Greg-R/t41_2_main_board/README.md

T41-2 Main Board Module

The documentation for this design is located here:
<https://kf5n.com/t41-2/main/>
