Greg-R/t41_2_main_board/doc/t41_2_main_board.pdf

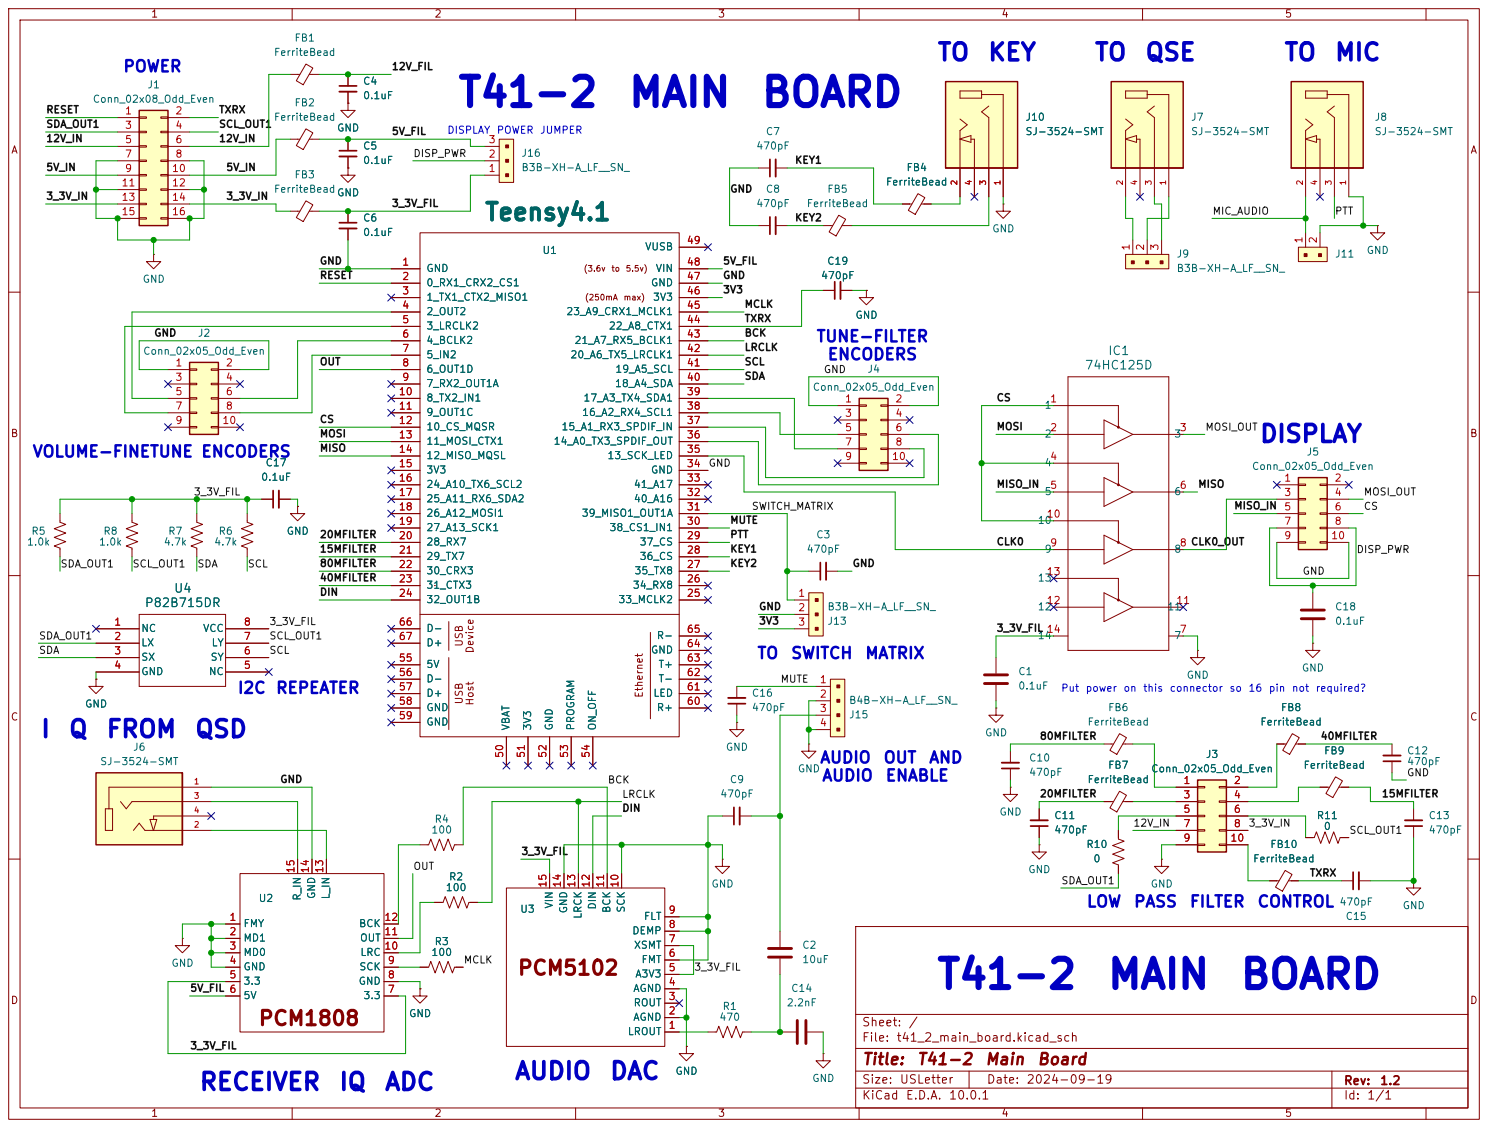
[picture p1: page 1]

DISPLAY POWER JUMPER T41-2 MAIN BOARD

Put power on this connector so 16 pin not required?

LRC 10 OUT 11 BCK 12 L_IN 13 GND 14 R_IN 15 U2 GND

LOW PASS FILTER CONTROL

Size: USLetter | Rev: 1.2
KiCad E.D.A. 10.0.1 | Id: 1/1
