Greg-R/t41_2_main_board/(list of files, drawings)

Other design files:
t41_2_main_board.dsn
