Greg-R/t41_2_main_board/t41_2_main_board.kicad_pcb

## KiCad design t41_2_main_board.kicad_pcb (2024-09-19)

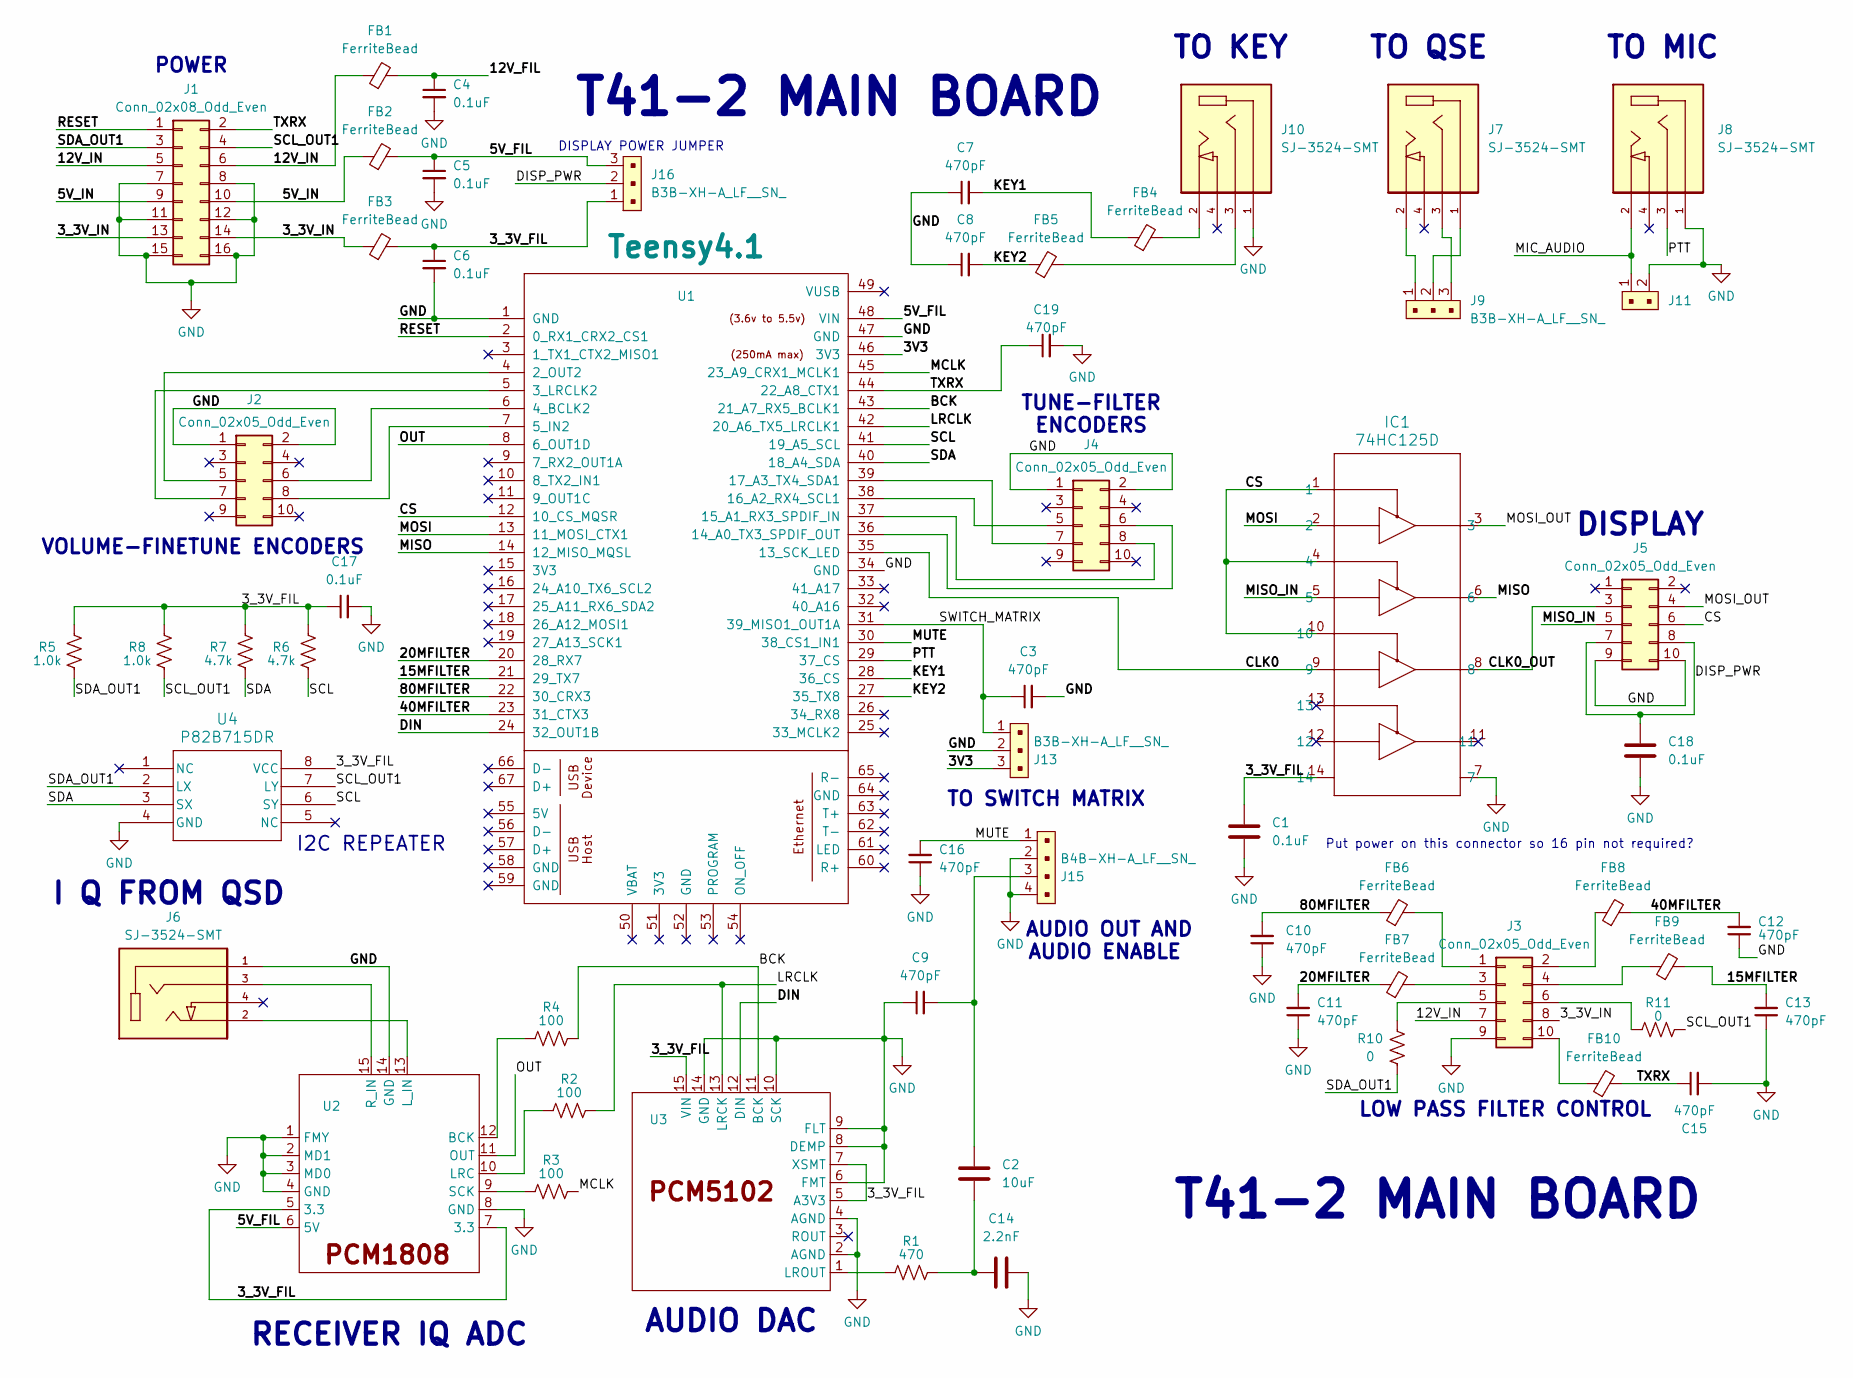
[picture p2: schematic t41_2_main_board.kicad_sch, T41-2 Main Board]

Parts:
C1, C4, C5, C6, C17, C18: 0.1uF; C_1206_3216Metric
C2: 10uF; C_1206_3216Metric
C3, C7, C8, C9, C10, C11, C12, C13, C15, C16, C19: 470pF; C_1206_3216Metric
C14: 2.2nF; C_1206_3216Metric
FB1, FB2, FB3, FB4, FB5, FB6, FB7, FB8, FB9, FB10: FerriteBead; L_1206_3216Metric
IC1: 74HC125D; SOIC-14_3.9x8.7mm_P1.27mm
J1: Conn_02x08_Odd_Even; IDC-Header_2x08_P2.54mm_Vertical
J2, J3, J4, J5: Conn_02x05_Odd_Even; IDC-Header_2x05_P2.54mm_Vertical
J6, J7, J8, J10: SJ-3524-SMT; CUI_SJ-3524-SMT; PARTREV 1.03
J9, J13, J16: B3B-XH-A_LF__SN_; PinHeader_1x3_P2.5mm_Drill1.1mm; MPN B3B-XH-A(LF)(SN); Digi-Key_PN 455-2248-ND
J11: B2B-XH-A_LF__SN_; PinHeader_1x2_P2.5mm_Drill1.1mm; MPN B2B-XH-A(LF)(SN); Digi-Key_PN 455-2247-ND
J15: B4B-XH-A_LF__SN_; PinHeader_1x4_P2.5mm_Drill1.1mm; MPN B4B-XH-A(LF)(SN); Digi-Key_PN 455-2249-ND
R1: 470; R_1206_3216Metric
R2, R3, R4: 100; R_1206_3216Metric
R5, R8: 1.0k; R_1206_3216Metric
R6, R7: 4.7k; R_1206_3216Metric
R10, R11: 0; R_1206_3216Metric
U1: Teensy4.1; Teensy41
U2: PCM1808_module
U3: PCM5102_module
U4: P82B715DR; SOIC-8_3.9x4.9mm_P1.27mm

Connections:
/3V3: J13.3, U1.46 (3V3)
/3_3V_FIL: C1.1, C6.1, C17.1, FB3.2, IC1.14, J16.1, R5.2, R6.2, R7.2, R8.2, U2.5 (3.3), U2.7 (3.3), U3.5 (A3V3), U3.7 (XSMT), U3.15 (VIN), U4.8 (VCC)
/3_3V_IN: FB3.1, J1.13, J1.14, J3.8
/5V_FIL: C5.1, FB2.2, J16.3, U1.48 (VIN), U2.6 (5V)
/5V_IN: FB2.1, J1.9, J1.10
/12V_FIL: C4.1, FB1.2
/12V_IN: FB1.1, J1.5, J1.6, J3.7
/15MFILTER: C13.2, FB9.2, U1.21 (29_TX7)
/20MFILTER: C11.2, FB7.1, U1.20 (28_RX7)
/40MFILTER: C12.2, FB8.2, U1.23 (31_CTX3)
/80MFILTER: C10.2, FB6.1, U1.22 (30_CRX3)
/BCK: R4.2, U1.43 (21_A7_RX5_BCLK1), U3.11 (BCK)
/CLK0: IC1.9, U1.35 (13_SCK_LED)
/CLK0_OUT: IC1.8, J5.3
/CS: IC1.1, IC1.4, IC1.10, J5.6, U1.12 (10_CS_MQSR)
/DIN: U1.24 (32_OUT1B), U3.12 (DIN)
/DISP_PWR: C18.1, J5.7, J5.8, J16.2
/KEY1: C7.2, FB4.1, U1.28 (36_CS)
/KEY2: C8.2, FB5.1, U1.27 (35_TX8)
/LRCLK: R2.2, U1.42 (20_A6_TX5_LRCLK1), U3.13 (LRCK)
/MCLK: R3.2, U1.45 (23_A9_CRX1_MCLK1)
/MIC_AUDIO: J8.2, J11.1
/MISO: IC1.6, U1.14 (12_MISO_MQSL)
/MISO_IN: IC1.5, J5.5
/MOSI: IC1.2, U1.13 (11_MOSI_CTX1)
/MOSI_OUT: IC1.3, J5.4
/MUTE: C16.2, J15.1, U1.30 (38_CS1_IN1)
/OUT: U1.8 (6_OUT1D), U2.11 (OUT)
/PTT: J8.3, U1.29 (37_CS)
/RESET: J1.1, U1.2 (0_RX1_CRX2_CS1)
/SCL: R6.1, U1.41 (19_A5_SCL), U4.6 (SY)
/SCL_OUT1: J1.4, R8.1, R11.2, U4.7 (LY)
/SDA: R7.1, U1.40 (18_A4_SDA), U4.3 (SX)
/SDA_OUT1: J1.3, R5.1, R10.1, U4.2 (LX)
/SWITCH_MATRIX: C3.1, J13.1, U1.31 (39_MISO1_OUT1A)
/TXRX: C15.1, C19.1, FB10.2, J1.2, U1.44 (22_A8_CTX1)
GND: C1.2, C3.2, C4.2, C5.2, C6.2, C7.1, C8.1, C9.1, C10.1, C11.1, C12.1, C13.1, C14.1, C15.2, C16.1, C17.2, C18.2, C19.2, IC1.7, J1.7, J1.8, J1.11, J1.12, J1.15, J1.16, J2.1, J2.2, J3.9, J4.1, J4.2, J5.9, J5.10, J6.1, J8.1, J10.1, J11.2, J13.2, J15.2, J15.4, U1.1 (GND), U1.34 (GND), U1.47 (GND), U2.1 (FMY), U2.2 (MD1), U2.3 (MD0), U2.4 (GND), U2.8 (GND), U2.14 (GND), U3.2 (AGND), U3.4 (AGND), U3.6 (FMT), U3.8 (DEMP), U3.9 (FLT), U3.10 (SCK), U3.14 (GND), U4.4 (GND)
unnamed: C2.2, C9.2, J15.3
unnamed: C2.1, C14.2, R1.2
unnamed: FB4.2, J10.2
unnamed: FB5.2, J10.3
unnamed: J2.5, U1.4 (2_OUT2)
unnamed: J2.6, U1.6 (4_BCLK2)
unnamed: J2.7, U1.5 (3_LRCLK2)
unnamed: J2.8, U1.7 (5_IN2)
unnamed: FB6.2, J3.1
unnamed: FB8.1, J3.2
unnamed: FB7.2, J3.3
unnamed: FB9.1, J3.4
unnamed: J3.5, R10.2
unnamed: J3.6, R11.1
unnamed: FB10.1, J3.10
unnamed: J4.5, U1.38 (16_A2_RX4_SCL1)
unnamed: J4.6, U1.36 (14_A0_TX3_SPDIF_OUT)
unnamed: J4.7, U1.39 (17_A3_TX4_SDA1)
unnamed: J4.8, U1.37 (15_A1_RX3_SPDIF_IN)
unnamed: J7.1, J9.2
unnamed: J7.2, J9.1
unnamed: J7.3, J9.3
unnamed: R4.1, U2.12 (BCK)
unnamed: R2.1, U2.10 (LRC)
unnamed: J6.2, U2.13 (L_IN)
unnamed: J6.3, U2.15 (R_IN)
unnamed: R3.1, U2.9 (SCK)
unnamed: R1.1, U3.1 (LROUT)

Notes on the sheet:
TO QSE
ENCODERS
TO SWITCH MATRIX
VOLUME-FINETUNE
I2C REPEATER
TO MIC
AUDIO OUT AND
I Q FROM QSD
TUNE-FILTER
DISPLAY POWER JUMPER
RECEIVER IQ ADC
DISPLAY
TO KEY
T41-2 MAIN BOARD
AUDIO ENABLE
Put power on this connector so 16 pin not required?
AUDIO DAC
POWER
LOW PASS FILTER CONTROL

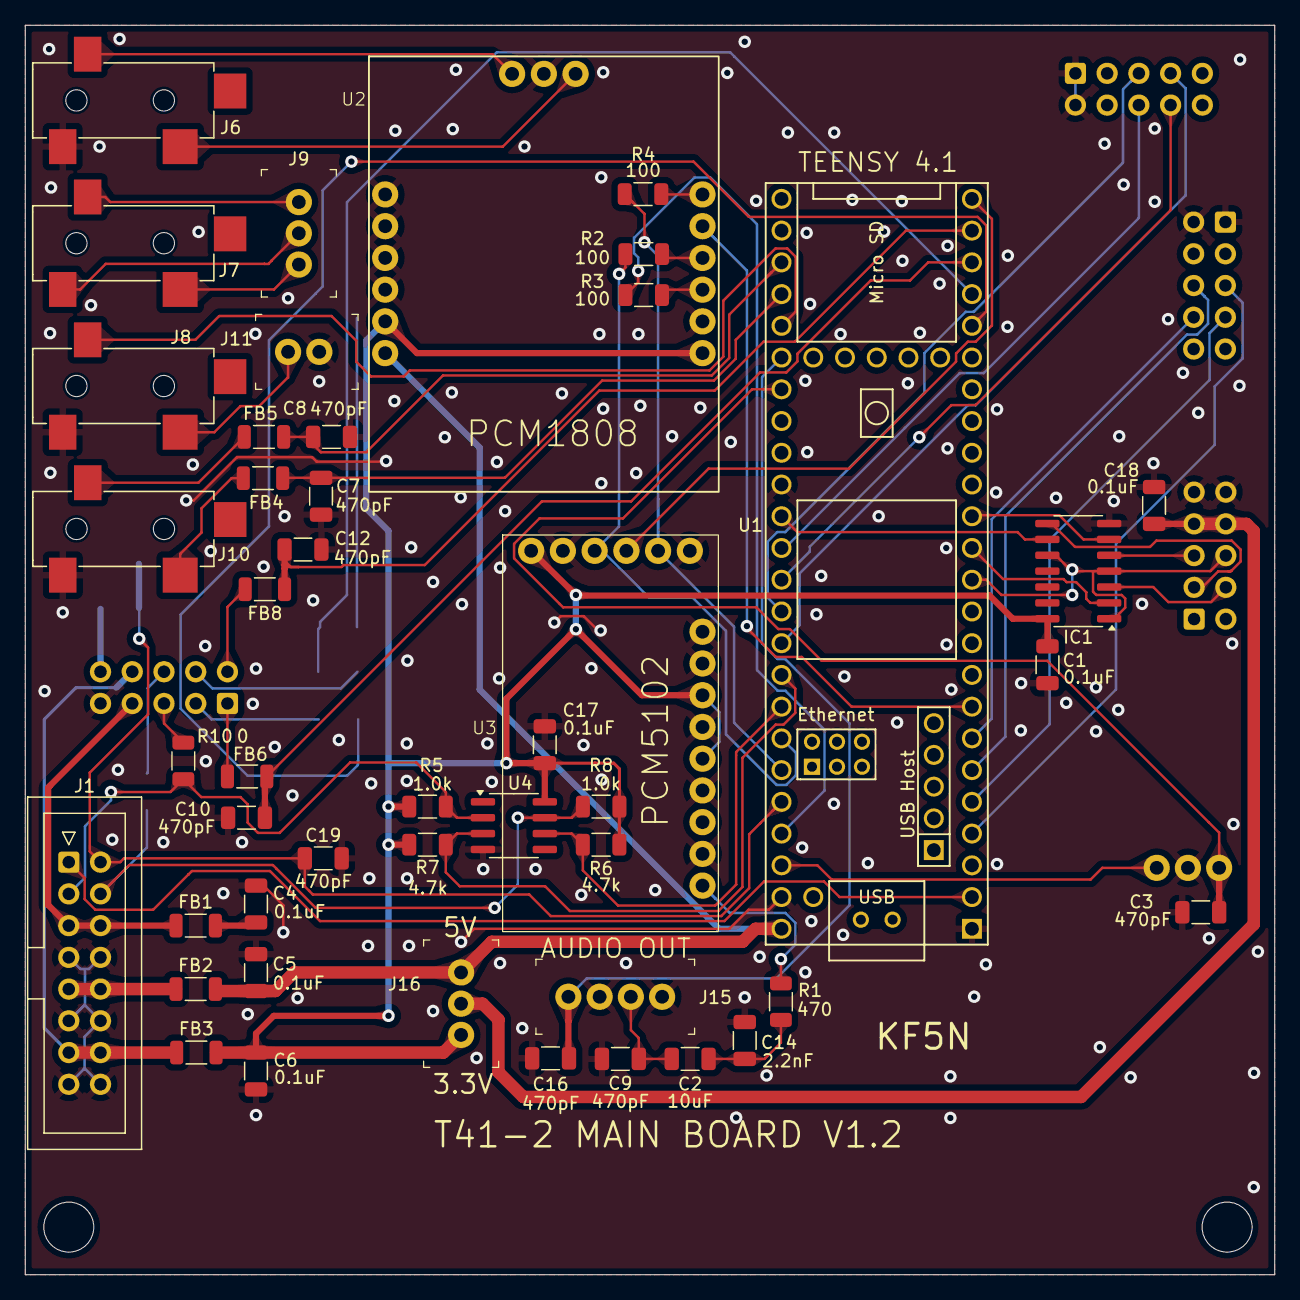
[picture p3: board t41_2_main_board.kicad_pcb from above]

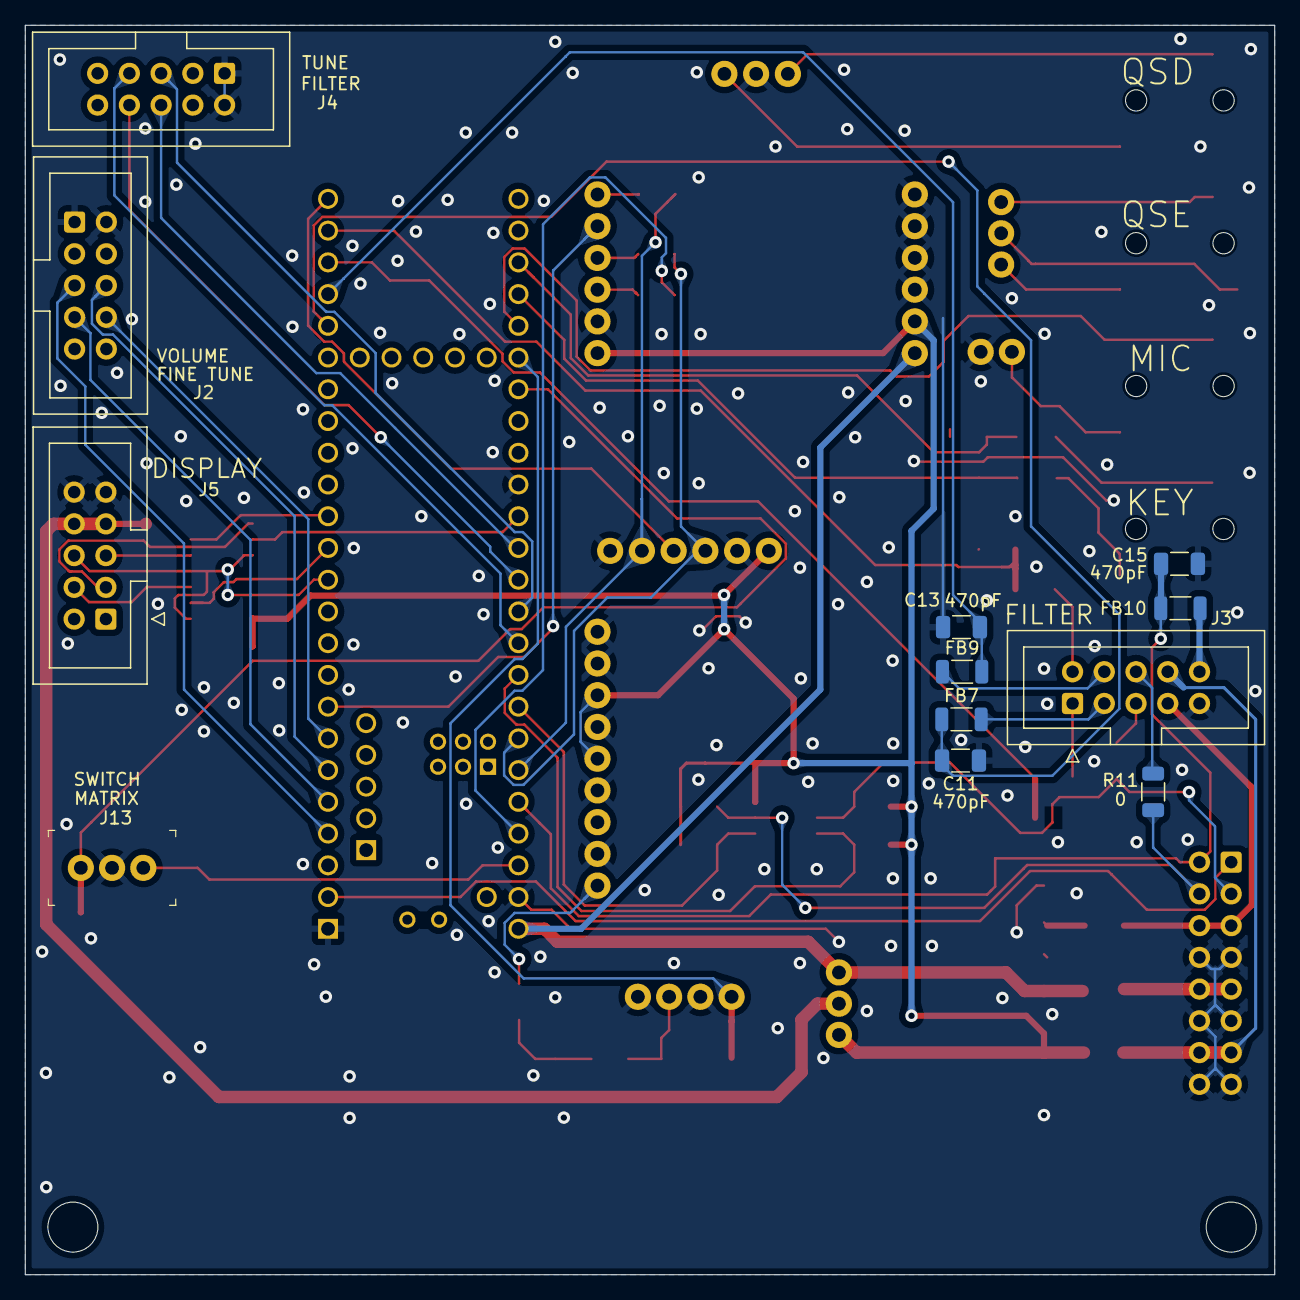
[picture p4: board t41_2_main_board.kicad_pcb from below]

Board: 2 copper layers, 100.0 x 100.0 mm, 58 parts (12 on the bottom side), 65 nets.
