Greg-R/t41_2_main_board/(commit log)

2024-08-25 Initial commit.
    [t41_2_main_board.kicad_pcb, t41_2_main_board.kicad_sch]
2024-08-26 Built footprints for data converters.
    [t41_2_main_board.kicad_pcb, t41_2_main_board.kicad_sch]
2024-08-28 Schematic nearing completion.
    [t41_2_main_board.kicad_pcb, t41_2_main_board.kicad_sch]
2024-08-29 Placement done.
    [t41_2_main_board.kicad_pcb, t41_2_main_board.kicad_sch]
2024-08-29 Closing in on finished layout.
    [t41_2_main_board.dsn, t41_2_main_board.kicad_pcb]
2024-08-30 Branching here to alternative layout.
    [t41_2_main_board.kicad_pcb]
2024-08-31 Audio routing is not good, starting another branch.
    [t41_2_main_board.dsn, t41_2_main_board.kicad_pcb, t41_2_main_board.kicad_sch]
2024-08-31 This new layout is excellent.
    [t41_2_main_board.dsn, t41_2_main_board.kicad_pcb]
2024-09-01 Branching prior to adding SPDIF.
    [t41_2_main_board.dsn, t41_2_main_board.kicad_pcb]
2024-09-01 To fab.
    [t41_2_main_board-B_Cu.gbr, t41_2_main_board-B_Mask.gbr, t41_2_main_board-B_Silkscreen.gbr, t41_2_main_board-Edge_Cuts.gbr, t41_2_main_board-F_Cu.gbr, t41_2_main_board-F_Mask.gbr, t41_2_main_board-F_Silkscreen.gbr, t41_2_main_board-NPTH.drl]
2024-09-10 V1.1 routes 0. Needs further clean-up.
    [t41_2_main_board.kicad_pcb, t41_2_main_board.kicad_sch]
2024-09-19 Fixed schematic route of 3.3 volts and 12 volts to filter connector.
    [t41_2_main_board-B_Cu.gbr, t41_2_main_board-B_Mask.gbr, t41_2_main_board-B_Silkscreen.gbr, t41_2_main_board-Edge_Cuts.gbr, t41_2_main_board-F_Cu.gbr, t41_2_main_board-F_Mask.gbr, t41_2_main_board-F_Silkscreen.gbr, t41_2_main_board-NPTH.drl]
2024-09-19 Layout re-do probably done.
    [t41_2_main_board-B_Cu.gbr, t41_2_main_board-B_Mask.gbr, t41_2_main_board-B_Silkscreen.gbr, t41_2_main_board-Edge_Cuts.gbr, t41_2_main_board-F_Cu.gbr, t41_2_main_board-F_Mask.gbr, t41_2_main_board-F_Silkscreen.gbr, t41_2_main_board-NPTH.drl]
2024-09-21 Added notes for PCB symbols and footprints.
2026-08-11 Repository clean-up.
    [t41_2_main_board-B_Cu.gbr, t41_2_main_board-B_Mask.gbr, t41_2_main_board-B_Silkscreen.gbr, t41_2_main_board-Edge_Cuts.gbr, t41_2_main_board-F_Cu.gbr, t41_2_main_board-F_Mask.gbr, t41_2_main_board-F_Silkscreen.gbr, t41_2_main_board-NPTH.drl]
